Johnnyklasa/LogicRail-FPGA-based-Rail-Control-Simulator/rtl/Station_B/RealClock.sv

//Autor:Jan Rutkowski
module RealClock #(
    parameter int CLK_FREQ = 65_000_000 
)(
    input logic clk,
    input logic rst_n,
    
    input logic sync_en,
    input logic [4:0] sync_hours,
    input logic [5:0] sync_minutes,
    
    output logic [4:0] hours,
    output logic [5:0] minutes,
    output logic minute_tick
);

    logic [4:0] hours_nxt;
    logic [5:0] minutes_nxt; 
    int clockcycles;

    assign minute_tick = (clockcycles == (CLK_FREQ) - 1);

    always_ff @(posedge clk or negedge rst_n) begin
        if (!rst_n) begin
            hours <= 1'b0;
            minutes <= 1'b0;
            clockcycles <= 0;
        end else if (sync_en) begin
            hours <= sync_hours;
            minutes <= sync_minutes;
            clockcycles <= 0; 
        end else begin
            hours <= hours_nxt;
            minutes <= minutes_nxt;
            if (minute_tick) begin
                clockcycles <= 0;
            end else begin
                clockcycles <= clockcycles + 1;
            end
        end
    end

    always_comb begin
        hours_nxt = hours;
        minutes_nxt = minutes;
        
        if (minute_tick) begin 
            minutes_nxt = minutes + 1;
            if (minutes == 59) begin
                hours_nxt = hours + 1;
                minutes_nxt = 0;
            end
        end
    end
endmodule
   
