Johnnyklasa/LogicRail-FPGA-based-Rail-Control-Simulator/rtl/Station_A/vga/VgaTiming.sv

//Autor: Karol Sitko
module vga_timing (
        input  logic clk,
        input  logic rst_n,
        output logic [10:0] vcount,
        output logic vsync,
        output logic vblnk,
        output logic [10:0] hcount,
        output logic hsync,
        output logic hblnk
    );

    timeunit 1ns;
    timeprecision 1ps;

    import vga_pkg::*;

    logic [10:0] vcount_nxt, hcount_nxt;
    logic vsync_nxt, vblnk_nxt, hsync_nxt, hblnk_nxt;
    
    
    always_ff @(posedge clk or negedge rst_n) begin
        if (!rst_n) begin
            hcount <= 11'b0;
            vcount <= 11'b0;
            hsync <= 1'b0;
            vsync <= 1'b0;
            hblnk <= 1'b0;
            vblnk <= 1'b0;
        end else begin
            hcount <= hcount_nxt;
            vcount <= vcount_nxt;
            hsync <= hsync_nxt;
            vsync <= vsync_nxt;
            hblnk <= hblnk_nxt;
            vblnk <= vblnk_nxt;
        end
    end
    
    always_comb begin
        hcount_nxt = hcount;
        vcount_nxt = vcount;
    
        if (hcount == HOR_TOTAL_TIME - 1) begin
            hcount_nxt = 11'b0;
    
            if (vcount == VER_TOTAL_TIME - 1) begin
                vcount_nxt = 11'b0;
            end
            else begin
                vcount_nxt = vcount + 1;
            end
    
        end
        else begin
            hcount_nxt = hcount + 1;
        end
    
        //hsync_nxt = (hcount_nxt >= HOR_SYNC_START) && (hcount_nxt < HOR_SYNC_START + HOR_SYNC_TIME);
        //vsync_nxt = (vcount_nxt >= VER_SYNC_START) && (vcount_nxt < VER_SYNC_START + VER_SYNC_TIME);
        hsync_nxt = (hcount >= HOR_SYNC_START - 1) && (hcount < (HOR_SYNC_START - 1) + HOR_SYNC_TIME);
        vsync_nxt = (vcount >= VER_SYNC_START - 1) && (vcount < (VER_SYNC_START - 1) + VER_SYNC_TIME);
    
        hblnk_nxt = (hcount_nxt >= HOR_PIXELS);
        vblnk_nxt = (vcount_nxt >= VER_PIXELS);
    end



endmodule
