Johnnyklasa/LogicRail-FPGA-based-Rail-Control-Simulator/(commit log)

2026-05-25 Readme change
    Updated the README to specify Basys3 and SPI in the hardware description.
2026-08-10 added basic sim features, some issues with crossroads to be fixed
    [DrawEntryTracks.sv, DrawInternalTracks.sv, DrawMouse.sv, DrawPlatforms.sv, DrawSemafor.sv, DrawTurnouts.sv, MapRenderer.sv, Map_pkg.sv]
2026-08-12 Prepared Main FSM, timetable and train generation Resolves#7
    [DrawSemafor.sv, DrawTurnouts.sv, MapRenderer.sv, Map_pkg.sv, RealClock.sv, RouteFSM.sv, Semafor.sv, Timetable_pkg.sv]
2026-08-16 Added functional simulation sructure. Resolves #7
    [DrawEntryTracks.sv, DrawInternalTracks.sv, DrawSemafor.sv, DrawTurnouts.sv, MapRenderer.sv, RealClock.sv, RouteFSM.sv, SRK_pkg.sv]
2026-08-18 Added Clock display, Fixed semaphore bugs. Resolves #9
    [DrawClock.sv, DrawSemafor.sv, DrawTurnouts.sv, MapRenderer.sv, Map_pkg.sv, RealClock.sv, RouteFSM.sv, SRK_pkg.sv]
2026-08-20 Added timetable display. Resolves #8
    [DrawTimetable.sv, TimetableRom.sv, TopVga.sv]
2026-08-31 fix(station-b): resolve synchronization and CDC violations in TopPanel
    - Removed IP Core clk_wiz_0 (PLL) from Station B architecture.
    - Unified clock domain of SRK and UART logic to native 100 MHz.
    - Cleaned up duplicate assignments resulting from the basys3.xdc file.
    - Updated build.tcl script to remove references to clk_wiz_0.
    - Fixed syntax error in TopPanelTB.sv file.
    [TopPanel.sv, TopPanelTB.sv, basys3.xdc]
2026-09-12 fix: resolve mouse coordinate bus skew by unifying clock domains and update technical report
    [MouseCtl.vhd, TopVga.sv, basys3.xdc]
